TYF009/AuraBar-T113S3/docs/requirements/README.md

# Product requirements entry

The current product definition is maintained under [product scope](../product/README.md), [capability status](../product/status.md) and [roadmap](../product/roadmap.md).

The original [requirements source](requirements-source.txt) and reference images remain historical inputs. Their vehicle, BLE and smart-home examples describe possible applications rather than completed integrations. Use the current capability matrix for demonstrations and release claims.
