TYF009/AuraBar-T113S3/hardware/docs/figure-index.md

# Hardware Figure Index / 硬件图像索引

The original Word file contains 26 media files and 27 image placements: image4.png is reused once. Every unique image is preserved byte-for-byte and embedded in the [bilingual circuit handbook](hardware-design-guide.md). Figure numbers below refer to Word media numbers, not placement count. Images retain their original language and annotations.

原始 Word 含 26 个媒体文件与 27 处图片引用，其中 image4.png 重复使用一次。每张独立图均按原始字节保留，并嵌入[双语电路手册](hardware-design-guide.md)。下表图号指 Word 媒体编号，不是引用次数。图片保留原始语言与标注。

This index records provenance, not ownership of third-party illustrations. Existing licensing and source notices continue to apply. The editable author draft is not part of the current public distribution. Published figure hashes and the final schematic PDF remain verifiable without it.

本索引记录来源，不据此认定第三方插图的所有权；原有许可与来源说明继续适用。作者可编辑原稿不属于当前公开交付资料；已发布图片的哈希和最终原理图 PDF 可独立校验。

## Word figures / Word 图片

| Word media / Word 媒体 | Preserved file / 保留文件 | SHA-256 |
|---|---|---|
| `image1.png` | [t113-s3-features.png](images/t113-s3-features.png) | `62799fa843b1853c88e8eb262bdb25364b16230c3314ffe1ced6cf84b06b8af4` |
| `image2.png` | [t113-s3-block-diagram.png](images/t113-s3-block-diagram.png) | `bdadd41c85f8cc633bd78e165c0a6b41f6a68b03a8db42b6282764eabeca89d6` |
| `image3.png` | [mcu-symbol-drawing.png](images/mcu-symbol-drawing.png) | `21fb891708a23ff65d17adc97d97df721b320c01d92efe1299849102fe85c72a` |
| `image4.png` | [clock-main-24m.png](images/clock-main-24m.png) | `8a717bfa47ee2471e9a6124066d75d0849dffcb1d204a858a0fa3e3de7a03615` |
| `image5.png` | [clock-rtc-32k-schematic.png](images/clock-rtc-32k-schematic.png) | `4423d62aa3d956ca8dfdf203f86693c520efe7d2b0d5c29815c9b741e9616916` |
| `image6.png` | [reset-circuit.png](images/reset-circuit.png) | `4a0fd6c3a9aae25e9184daf33a9c3191072dcd5fe8d7c60a795c4f86433f7278` |
| `image7.png` | [power-tree-evb-reference.png](images/power-tree-evb-reference.png) | `c9db43a3922a80c57259d68b4980fc879f31926fea43cb48ecd5992fe1de9cb2` |
| `image8.png` | [power-pmic-option.png](images/power-pmic-option.png) | `29be96f791e7d860a90a0f52fd793eab9da36670a178e7f72e636575cbb326fe` |
| `image9.png` | [power-dcdc-discrete.png](images/power-dcdc-discrete.png) | `c8041ed5d22cf9c6516211073e1334d376662444d9880dc5966b329ebf470bb0` |
| `image10.jpeg` | [power-rails-original.jpeg](images/power-rails-original.jpeg) | `92b059927f96c7b6f891ce33fae12bcb8b1fa39ac003f6d189f6f12032db8357` |
| `image11.png` | [power-decoupling.png](images/power-decoupling.png) | `a49b2c3c73543fc75946ea94fdcdd2ab361ab2ca16d5727ba76ab220e24d4416` |
| `image12.png` | [mcu-final-schematic.png](images/mcu-final-schematic.png) | `bc0bc5aaf7b7fdfc6632f7177ffddbaf79b5bffbb05918eb99ee26b3761c3bc7` |
| `image13.png` | [dram-config.png](images/dram-config.png) | `b1f667ab438a1727dbf19114109fe0e63fbc615d4527cfc115a075fa0986ebeb` |
| `image14.png` | [spi-nand-flash.png](images/spi-nand-flash.png) | `ef73d651e9db0519937a6fa1069b54ab254b9f1f6f31cb6b4fb0d506352c0ad1` |
| `image15.png` | [usb-debug-typec.png](images/usb-debug-typec.png) | `a220633556aaf15f83e93468bdd64c5bca7633b69ac5e9838bfeea36932975ea` |
| `image16.png` | [led-and-button.png](images/led-and-button.png) | `d5c66affe8d34bc0ddedb66c505f0974dbf41b99f6f794f2923f67121a105852` |
| `image17.png` | [uart3-debug-port.png](images/uart3-debug-port.png) | `015a64a17f55a3aa2d7fa07e971069aeb6475c600863d1f46578f10573466e2b` |
| `image18.png` | [mic-reference-circuit.png](images/mic-reference-circuit.png) | `b4634e4f69e8a3eed55981fd05dd9fb664c376732400094046b3b22b84167fb1` |
| `image19.png` | [mic-circuit.png](images/mic-circuit.png) | `74eb14ce1370c5ff19536945f44ee7d9e384ec0fb925c6298d67b955debb1118` |
| `image20.png` | [amplifier-lm4890-reference.png](images/amplifier-lm4890-reference.png) | `aa248f0d218de2a6ee84b3f4ba2f631d898b82d2ae265144ecd0ae48c1ab415e` |
| `image21.png` | [amplifier-output.png](images/amplifier-output.png) | `45d4e2a4b0cf79c51866d3e8cae4511a5ea9ae42168ac613bc5ff2df86c8666b` |
| `image22.png` | [wifi-module-rtl8723ds.png](images/wifi-module-rtl8723ds.png) | `179e7cc85f44807aef63ca1f46c3072f7bf1f4976c97b21845c6faa8df4b2fda` |
| `image23.png` | [wifi-mcu-connections.png](images/wifi-mcu-connections.png) | `5b856f413b36e7b52481931f7c734a0487918124b604b92707a0cca842c1b97c` |
| `image24.png` | [mipi-lcd-fpc30.png](images/mipi-lcd-fpc30.png) | `48b98857427befc333d485a8e633889a157c9eb55a579730a5106d52665755b7` |
| `image25.png` | [backlight-mt9201-reference.png](images/backlight-mt9201-reference.png) | `26e18df6ca64285546816d3808fc95a0048de85c49e0b56f0f460203133f5bbe` |
| `image26.png` | [backlight-mt9201.png](images/backlight-mt9201.png) | `4467c9beee48d6ec958b4ab612f53b9de38d2c0144bfea800f51f4fabc5259c7` |

## Final schematic previews / 最终原理图预览

All seven PDF pages are rendered at 2× PDF point scale (144 dpi) without changing the PDF. The vector PDF is the preferred source for inspecting small labels. Page previews are embedded in their corresponding handbook sections.

全部七页以 PDF 点尺寸的两倍比例（144 dpi）渲染，不修改原 PDF。细小标注优先查看矢量 PDF，预览图分别嵌入手册对应章节。

| Page / 页 | Sheet / 图页 | Preview / 预览 |
|---|---|---|
| 1 | T113S3 | [01-t113s3.png](images/schematic/01-t113s3.png) |
| 2 | NET | [02-net.png](images/schematic/02-net.png) |
| 3 | POWER | [03-power.png](images/schematic/03-power.png) |
| 4 | CONNECT | [04-connect.png](images/schematic/04-connect.png) |
| 5 | AUDIO | [05-audio.png](images/schematic/05-audio.png) |
| 6 | FLASH | [06-flash.png](images/schematic/06-flash.png) |
| 7 | DISPLAY | [07-display.png](images/schematic/07-display.png) |

## Additional references / 补充参考

The handbook also retains the existing architecture diagram, RTC pin detail, power-domain copy, USB connector comparison photos, indicator and touch reference. Historical filenames do not establish revision status; captions explain the content and alternatives.

手册同时保留已有架构图、RTC 引脚细节、电源域副本、USB 连接器对比照片、指示灯与触摸参考。历史文件名不能确定版本状态，具体内容与备选方案在图注中说明。

[Machine-readable hashes / 机器可读哈希清单](figure-provenance.json) · [Final PDF / 最终 PDF](../schematic/AuraBar-Schematic-v1.0.pdf)
