TYF009/AuraBar-T113S3/docs/product/repository-review.md

# Product delivery review / 产品交付复盘

Review date: 2026-10-27. Scope: public repository presentation, source access, reproducibility and delivery evidence. This is a documentation/release review, not a new hardware acceptance run.

复盘日期：2026-10-27。范围为公开展示、源码入口、复现条件与交付证据，本次没有新增硬件实测。

## What the repository now delivers / 当前交付内容

| Area / 方面 | Assessment / 判断 | Evidence / 依据 |
|---|---|---|
| Product narrative / 产品叙事 | Clear core experience: task awareness, review cards and audio / 核心体验集中于任务、结果与音频 | [English](../../README.md), [中文](../../README.zh-CN.md) |
| Demonstration / 演示 | Film, feature GIFs, cover and bilingual subtitles / 影片、GIF、封面与双语字幕 | [Media guide](demo.md) |
| Hardware explanation / 硬件说明 | Editable electronics plus illustrated bilingual guide; author draft excluded from current tree / 电子工程与双语图文，当前目录不含原稿 | [Hardware](../hardware/README.md) |
| Evaluation / 企业评估 | Documented system boundary and integration stages / 明确系统边界与集成阶段 | [Integration brief](integration-brief.md) |
| Reproduction / 复现 | Separate paths for computer tests, matching boards and new electronics / 区分电脑、兼容板卡与新制造 | [Reproduction guide](../guides/reproduce.md) |
| Delivery availability / 下载交付 | Source is public; prepared binaries remain drafts / 源码公开，二进制仍为草稿 | [Release catalog](../releases/README.md) |

**Positioning:** a working, documented engineering platform suitable for product evaluation and adaptation. It is not yet an independently reproducible blank-board-to-production delivery.

**定位结论：**已有可工作的软硬件基础和清晰文档，适合产品评估与二次开发；尚未形成从空白板卡到量产交付的独立完整闭环。

## Highest-return next work / 后续投入优先级

| Priority / 优先级 | Work / 工作 | Done when / 完成标准 |
|---|---|---|
| P0 | Public application release / 正式提供可下载应用包 | Resolve bundled resource notices, verify manifest/hash and rollback, publish a scoped prerelease / 补齐资源声明、校验与回退后公开预发布包 |
| P0 | Reproducible system baseline / 可复现系统基线 | Document legally obtainable BSP/SDK/resources, pin versions, have a second clean environment build and run / 明确可取得的系统和 SDK，独立环境构建运行 |
| P1 | Appliance-like startup / 设备化启动体验 | One documented startup/service path, restart handling and retained user settings verified on board / 验证统一启动、重启恢复与设置保留 |
| P1 | Close physical acceptance / 完成实物验收 | Record notification/music recovery, extended playback, repeated connection cycles and boot tests / 记录提示恢复、长时间播放、反复连接及开机测试 |
| P1 | Deployment security / 部署安全 | Define non-development transport, authentication, update trust and sensitive-data handling for the intended environment / 定义非调试传输、认证、更新信任与数据处理 |
| P2 | Publication and audience / 对外传播 | Upload film, add a real YouTube link, collect feedback through reproducible use cases / 发布影片并围绕可复现使用流程收集反馈 |
| P2 | New scenarios / 扩展场景 | Demonstrate one real appliance/data adapter before adding more concept scenarios / 先完成一个真实数据接入，再扩展场景 |

The first four items improve customer confidence more than adding another visual theme. They make “inspect → obtain → run → recover” repeatable. Production commitments additionally require manufacturing, environmental and supply-chain evidence appropriate to the deployment.

前四项比新增一套视觉皮肤更能提升客户信任，因为它们把“看懂—取得—运行—恢复”变为可重复的流程。量产承诺还需要与实际场景相匹配的制造、环境和供应链依据。

## Source-publication boundary / 公开资料边界

The current hardware tree excludes editable Word author drafts. Published technical analysis, figures, EDA files, schematics and BOM remain available. The integrity check verifies figures without the draft and rejects Word files inside the hardware tree.

当前硬件目录不包含可编辑 Word 原稿，公开技术分析、图片、EDA、原理图和 BOM 保留。检查脚本无需原稿即可验证图片，并阻止硬件目录再次加入 Word。

Removing a tracked file does not erase earlier Git commits, historical branches, pull-request refs or copies already downloaded. This update does not rewrite history. Complete historical removal requires a separately coordinated repository-history cleanup, and cannot revoke external copies.

删除当前文件不会抹去旧提交、历史分支、PR 引用或已下载副本。本次未重写历史；如需进一步清理旧记录，应单独安排历史迁移，也无法撤回外部已有副本。

## Verification scope / 校验范围

Repository checks validate local documentation links, media hashes, version consistency and release metadata. Hardware checks verify 26 source figures, 27 recorded placements, all seven final schematic previews and all 41 embedded illustrations. Software behavior and acceptance records are unchanged by this presentation update.

仓库检查覆盖文档链接、媒体哈希、版本一致性和发布元数据；硬件检查覆盖 26 张来源图片、27 处记录、七页最终原理图预览与全部 41 张嵌入图片。本次展示更新未改变软件行为和原验收记录。

[Capability matrix](status.md) · [Roadmap](roadmap.md) · [CI](https://github.com/TYF009/AuraBar-T113S3/actions)
