TYF009/AuraBar-T113S3/docs/README.md

# Documentation

Choose an entry by the job you need to do. The source preview is 0.4.0-alpha.2; hardware and application concepts have separate readiness records.

| Reader | Start here | Continue with |
|---|---|---|
| Customer or integration partner | [Integration brief](product/integration-brief.md) · [Product film](product/demo.md) | [Capabilities](product/status.md), [roadmap](product/roadmap.md) |
| Reproduction / 复现 | [Reproduction guide](guides/reproduce.md) | [Development](development/README.md), [hardware](hardware/README.md) |
| Device user | [Quick start](guides/quickstart.md) | [Install/recover](guides/installation.md), [troubleshoot](guides/troubleshooting.md) |
| Software developer | [Development](development/README.md) | [Architecture](architecture/README.md), [protocol](architecture/task-protocol.md), [validation](testing/README.md) |
| Hardware developer | [Hardware design guide / 硬件设计指南](hardware/README.md) | [Circuits](../hardware/docs/hardware-design-guide.md), [interfaces](hardware/interfaces.md) |
| Release maintainer | [Release catalog](releases/README.md) | [Release procedure](releases/process.md), [changelog](../CHANGELOG.md) |

## Evidence and source records

- [Music & Focus acceptance](software/release-0.2.0-alpha.1.md)
- [Desktop Link acceptance](software/release-0.3.0-alpha.1.md)
- [Coding Companion first acceptance](software/release-0.4.0-alpha.1.md)
- [Scrolling update and owner confirmation](software/release-0.4.0-alpha.2.md)
- [Original software engineering review](software/review-v0.2.md)
- [Asset classifications and provenance](../assets/README.md)

中文首页见 [README.zh-CN.md](../README.zh-CN.md)。使用者可从快速开始进入，工程细节按产品、硬件、架构、开发、测试和发布组织。
