TYF009/AuraBar-T113S3/docs/requirements/requirements-source.txt

设计一款通用的嵌入式产品解决方案。可以成为个人桌面助理屏，可以触摸控制、可以通过屏幕查看时间、查看天气、设置番茄时钟，一个长且大的屏幕，放在使用者工作台上，有熄屏控制、音量控制功能，后续可扩展小游戏、HID快捷键，也可以加入BLE Mesh组网多设备中控功能。或者可以内嵌入冰箱，或成为汽车的数字仪表盘显示里程，目前档位以及当前速度。之所以不用STM32F103芯片是因为主频太低了，这会导致驱动较大屏幕时，刷新帧率不够，另外没有显示接口，没有音频编解码器等等。
