TYF009/AuraBar-T113S3/docs/software/release-0.4.0-alpha.1.md

# Coding Companion 0.4.0-alpha.1 — preview acceptance record

Date: 2026-10-25. This is an application preview with the remaining checks listed below.
The Music & Focus 0.2 and Desktop Link 0.3 iterations remain on their existing branches.

## Delivered source

- A standard-library Python Codex CLI adapter consumes actual exec JSONL events.
- A schema-constrained review card separates AI summary, observed command exits,
  AI verification notes and human follow-up actions.
- A model-reported blocked outcome is not shown as a completed task.
- Per-run local prompt, event, stderr and result files; bounded input/events,
  local cancellation, timeout, and result preservation if delivery fails.
- Optional schema-1 evidence/next_step fields retain older-reader compatibility.
- Native task-page source adds Summary / Evidence / Next tabs and scrollable text.
- Product scope, setup, example prompt and package/deploy profile updated for 0.4.

## Verified on the development computer and USB transport

The Python regression suite covers: command exits and duplicate events, UTF-8 bounds,
card validation, invalid/missing results after a zero CLI exit, model-reported blockers,
initial-delivery failure preventing execution, timeout, local result preservation after
service loss, and the existing companion authentication/command tests.
The test CLI is a local fixture; these regressions do not invoke a model.

Separately, an actual logged-in Codex CLI (0.164.0-alpha.11.1) completed a Chinese
static review of a small percentage function supplied in the task. The card identified
unknown/zero denominator handling and follow-up boundary tests, and explicitly stated
that no commands, tests or file modifications were performed. The adapter recorded
zero observed command exits, saved the full result, and the USB bridge delivered the
matching task id and Chinese result to /tmp/aurabar-tasks.json on the real board.
This verifies a real model result and USB delivery, not an end-to-end coding/test verdict.

An earlier attempt using a stale system proxy timed out and reported failure. Retrying
with the current system proxy restored model connectivity. A project-file reading task
then returned a card stating that the local Codex shell sandbox could not initialize
due to access denial on its sandbox helper directory. That did not verify file reading
or test execution. The blocked-outcome mapping was added after this observation and is
covered by regression tests; the earlier task was not retroactively rewritten.

## Pending acceptance / 待验收

- The owner confirmed all three tabs and long-text scrolling work, but reported
  choppy scrolling. Alpha.2 addresses redundant UI updates; performance acceptance
  remains separate from this functional confirmation.
- Recheck terminal notification audio during music, followed by music recovery.
- Resolve the computer's Codex sandbox permission issue before claiming project-file
  reading, command execution or actual test-suite integration on this machine.

## Ubuntu build, real board and package

The VMware runtime share was re-enabled and mounted in Ubuntu; the owner restarted
the existing build helper. The full Ubuntu regression job coding-04-tests-01 exited
zero, including all 13 Python tests, native task model/HTTP worker/music tests, and
ARM test executable compilation. The new task-model executable also passed on T113.

A fresh RelWithDebInfo T113 build (coding-04-build-01) exited zero. The 4,734,664-byte
binary was installed at /usr/bin/aurabar-coding-companion-0.4.0-alpha.1 and returned
the correct version. Host and device SHA256 both matched:

```text
b10243bbea4a45a2aa9138a964e80333cc3ba38b71605298c3b6dc6065747de7
```

The old display process was stopped and the new app started with --tasks and the
existing USB snapshot path. Framebuffer inspection showed Coding Companion, all
three tabs, a connected heartbeat, Chinese AI summary text and its scroll bar.
Original /usr/bin/demo, the 0.2/0.3 executables and boot configuration were preserved.

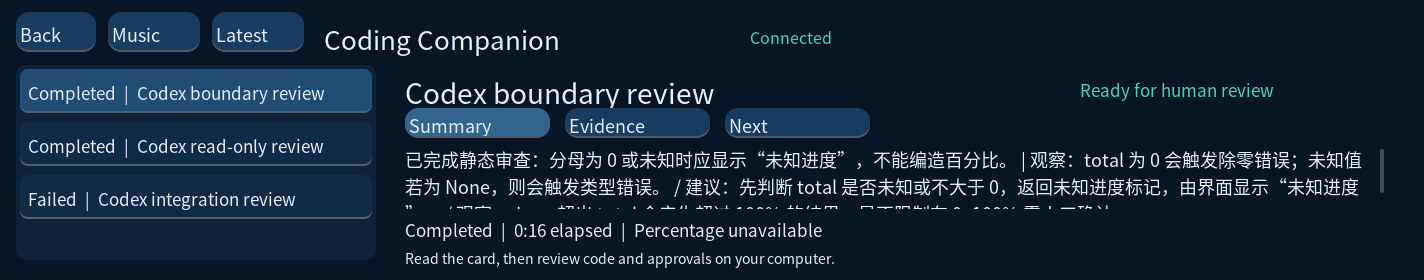
[picture p14: docs/software/images/coding-summary-board.png]
Actual T113 framebuffer: Coding Companion summary


The archive aurabar-coding-companion-0.4.0-alpha.1-t113.tar.gz passed verification of
all 142 manifest files, including the adapter, schema and sample prompt. It is an
application upgrade, not a bootable firmware image. Archive SHA256:

```text
0c86230fc2f42b2b398ad83f4ed8dd034dd865e27605afe21b51b203acd8d412
```

## Scope limits

This tracks tasks launched by the companion, not every conversation in the desktop
Codex app. It does not offer screen approvals, task launch/cancel buttons, durable
task storage, automatic startup, whole-system flashing or a bundled local model.
AI-generated summaries and outcomes still need human review.

See [setup](../../software/companion/README.md) and [product scope](coding-companion.md).
