TYF009/AuraBar-T113S3/assets/renders/ai-workspace.webp

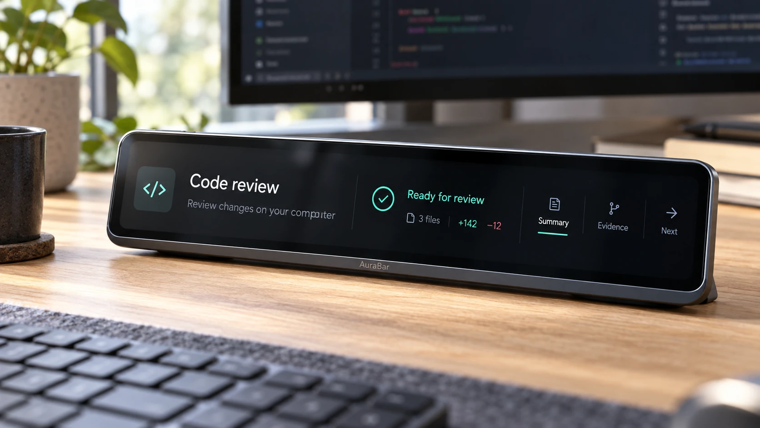
assets/renders/ai-workspace.webp
