TYF009/AuraBar-T113S3/docs/requirements/images/car-dashboard-example.png

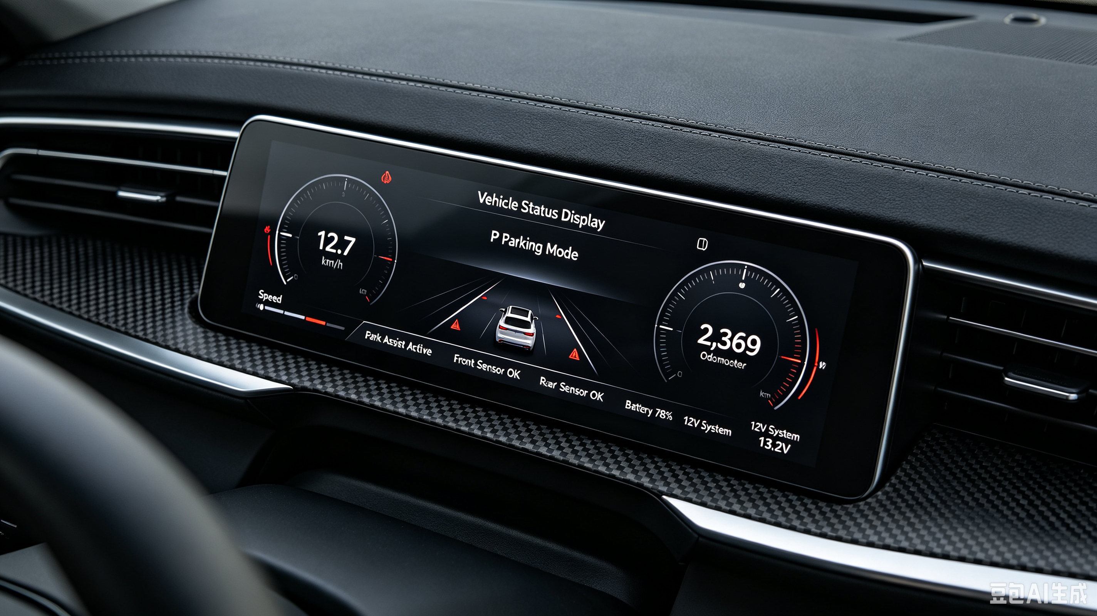
docs/requirements/images/car-dashboard-example.png
