TYF009/AuraBar-T113S3/docs/requirements/images/fridge-example.png

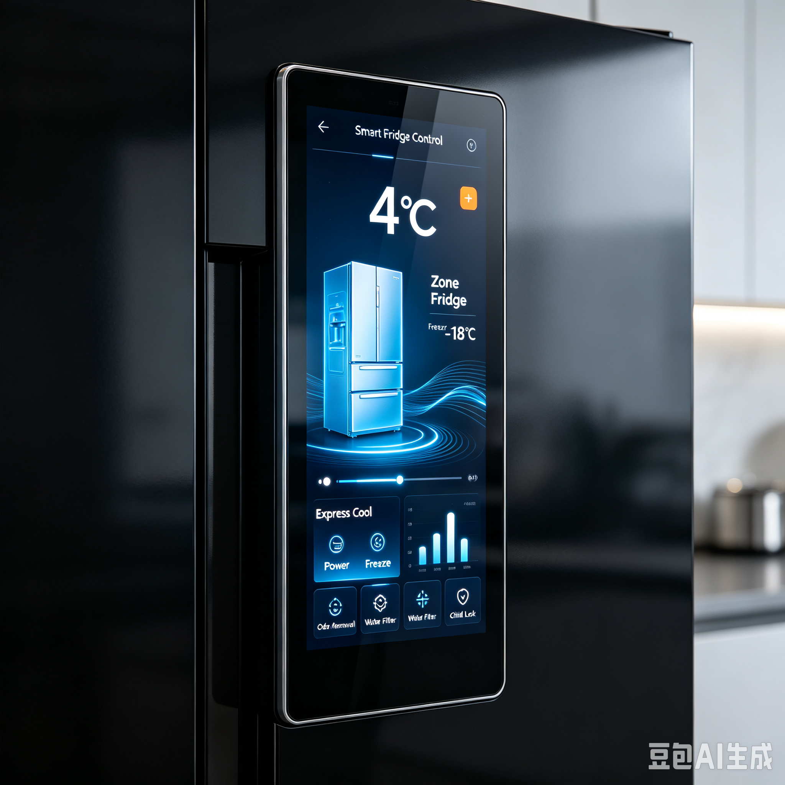
docs/requirements/images/fridge-example.png
