TYF009/AuraBar-T113S3/hardware/schematic/dxf/T113S3.dxf

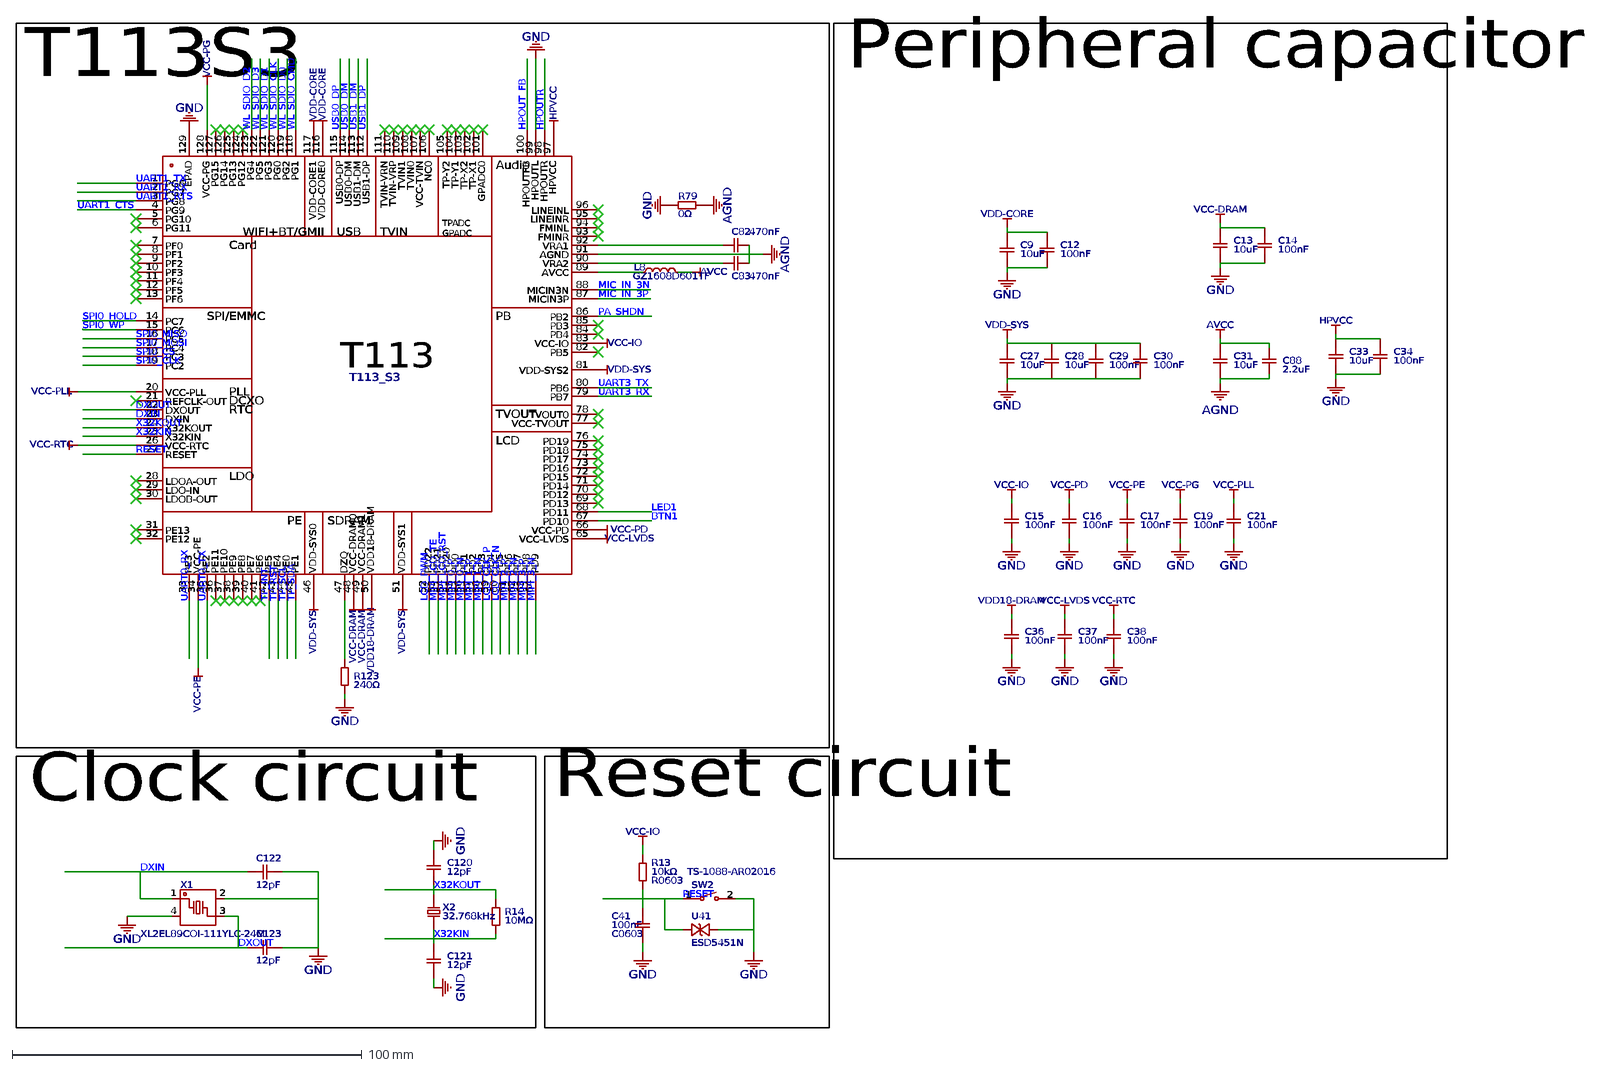
[picture p19: CAD file, 2026-10-07]
hardware/schematic/dxf/T113S3.dxf
Peripheral capacitor
Reset circuit
Clock circuit
T113S3
X1
XL2EL89COI-111YLC-24M
1
3
4
2
GND
AGND
R14
10MΩ
R13
R0603
10kΩ
T113_S3
WIFI+BT/GMII
DCXO
PLL
LDO
TPADC GPADC
Audio
PE
SDRAM
LCD
SPI/EMMC
Card
RTC
TVOUT
PB
TVIN
USB
T113
PG6
PG7
PG8
PG9
PG10
5
PG11
6
PF0
7
PF1
8
PF2
9
PF3
10
PF4
11
PF5
12
PF6
13
PC7
14
PC6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
