TYF009/AuraBar-T113S3/hardware/schematic/dxf/POWER.dxf

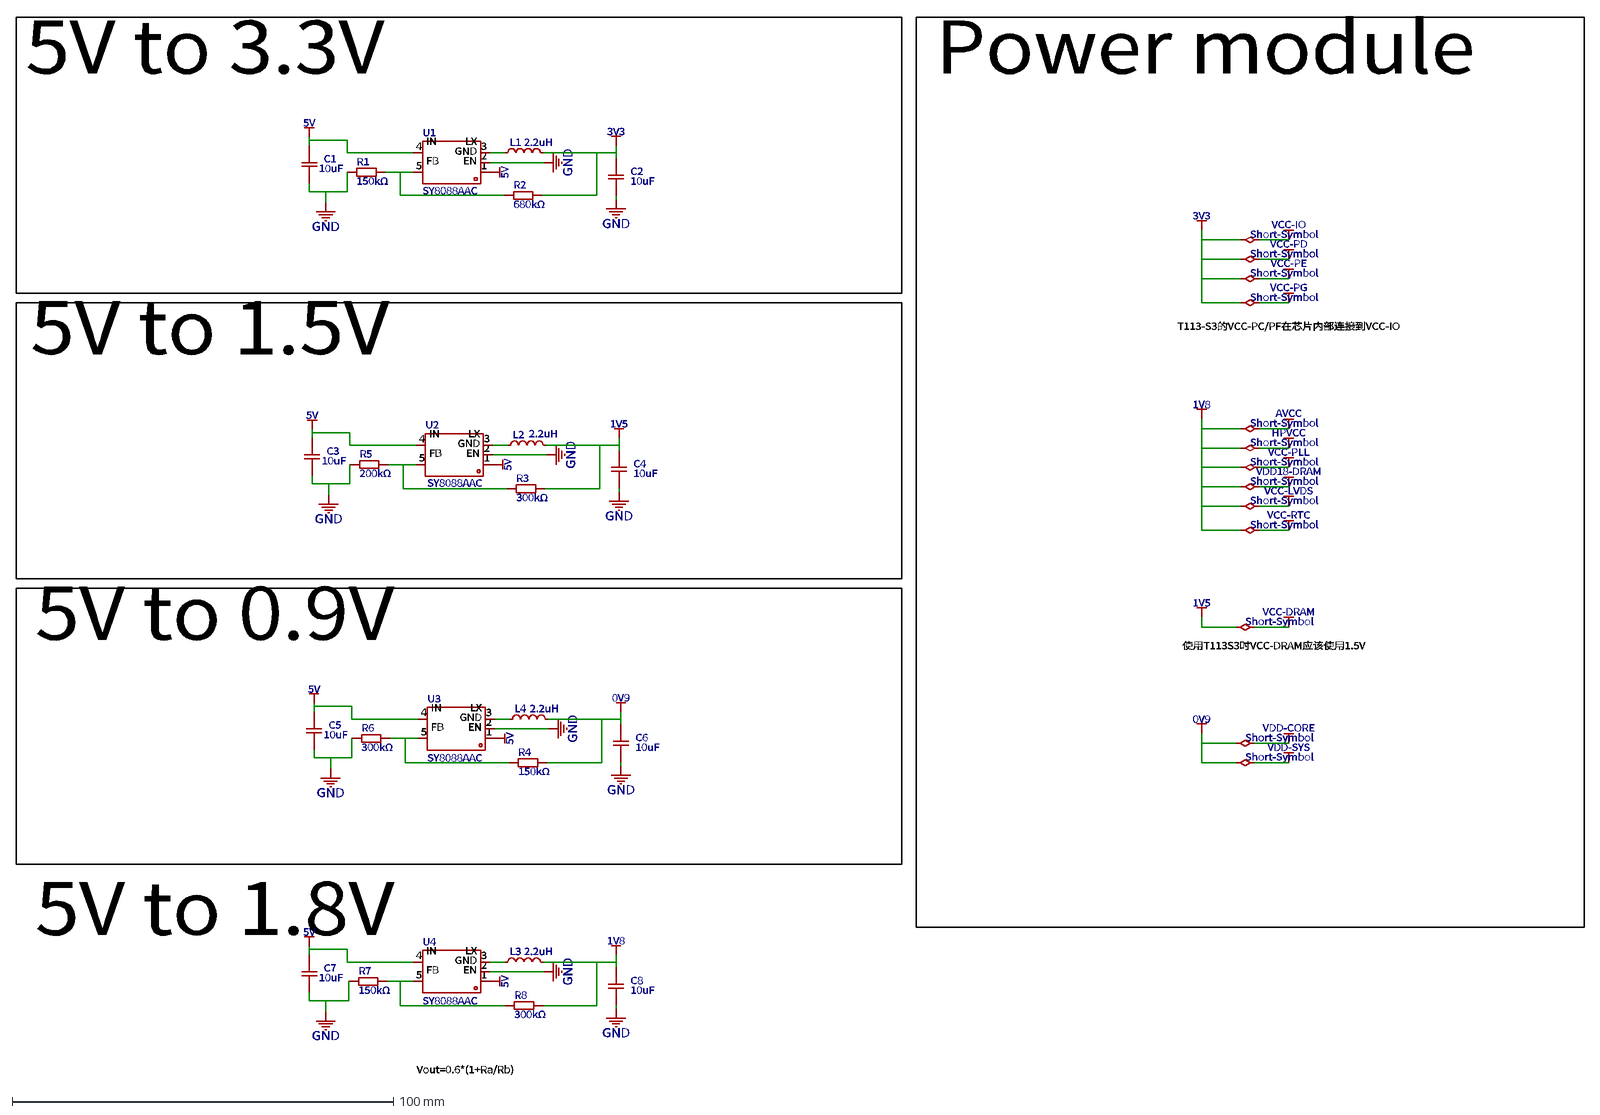
[picture p20: CAD file, 2026-10-07]
hardware/schematic/dxf/POWER.dxf
Vout=0.6*(1+Ra/Rb)
Power module
5V to 1.8V
5V to 0.9V
5V to 1.5V
5V to 3.3V
T113-S3的VCC-PC/PF在芯片内部连接到VCC-IO
使用T113S3时VCC-DRAM应该使用1.5V
U1
SY8088AAC
EN
1
GND
2
LX
3
IN
4
FB
5
U2
U3
U4
R1
150kΩ
R4
R7
R2
680kΩ
C1
10uF
C2
C3
C4
C5
C6
C7
C8
5V
3V3
1V5
0V9
1V8
R3
300kΩ
R5
200kΩ
R6
R8
VDD-CORE
VDD-SYS
AVCC
HPVCC
VCC-PLL
VDD18-DRAM
VCC-LVDS
VCC-RTC
VCC-IO
VCC-PD
VCC-PE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
