TYF009/AuraBar-T113S3/hardware/schematic/dxf/FLASH.dxf

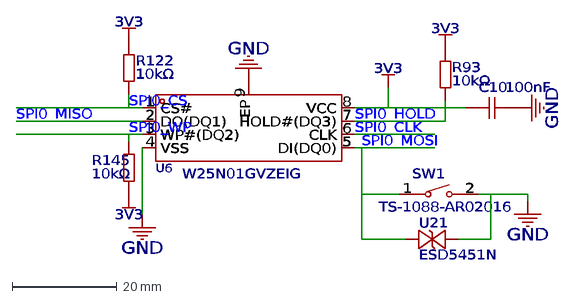
[picture p21: CAD file, 2026-10-07]
hardware/schematic/dxf/FLASH.dxf
GND
3V3
C10
100nF
SW1
TS-1088-AR02016
2
1
R93
10kΩ
R122
R145
U21
ESD5451N
U6
W25N01GVZEIG
CS#
DO(DQ1)
WP#(DQ2)
3
VSS
4
DI(DQ0)
5
CLK
6
HOLD#(DQ3)
7
VCC
8
EP
9
SPI0_HOLD
SPI0_CLK
SPI0_WP
SPI0_MOSI
SPI0_MISO
SPI0_CS
