TYF009/AuraBar-T113S3/hardware/schematic/dxf/AUDIO.dxf

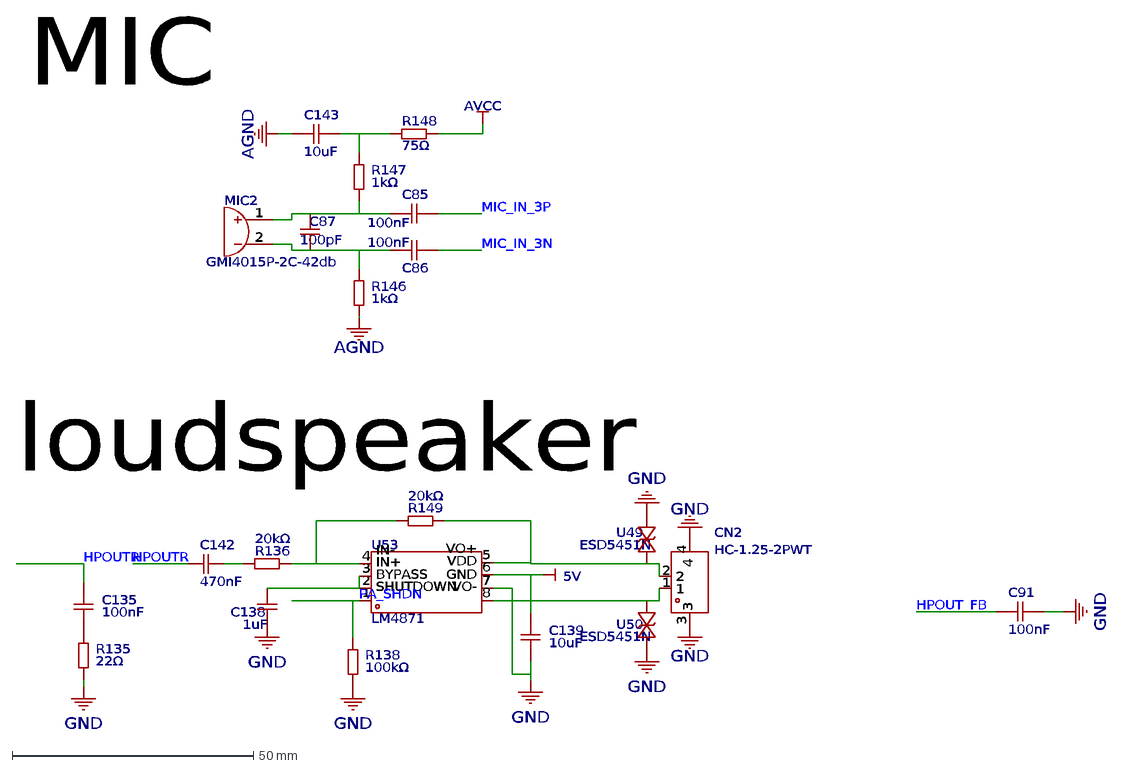
[picture p22: CAD file, 2026-10-07]
hardware/schematic/dxf/AUDIO.dxf
MIC
loudspeaker
C85
100nF
C86
C91
AVCC
5V
AGND
GND
C135
C139
10uF
C143
U49
ESD5451N
U50
C142
470nF
C87
100pF
R135
22Ω
R136
20kΩ
R149
C138
1uF
R138
100kΩ
CN2
HC-1.25-2PWT
1
2
3
4
R146
1kΩ
R147
R148
75Ω
MIC2
GMI4015P-2C-42db
U53
LM4871
SHUTDOWN
BYPASS
IN+
IN-
VO+
5
VDD
6
7
VO-
8
MIC_IN_3P
PA_SHDN
HPOUTR
HPOUT_FB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
