TYF009/AuraBar-T113S3/hardware/schematic/dxf/NET.dxf

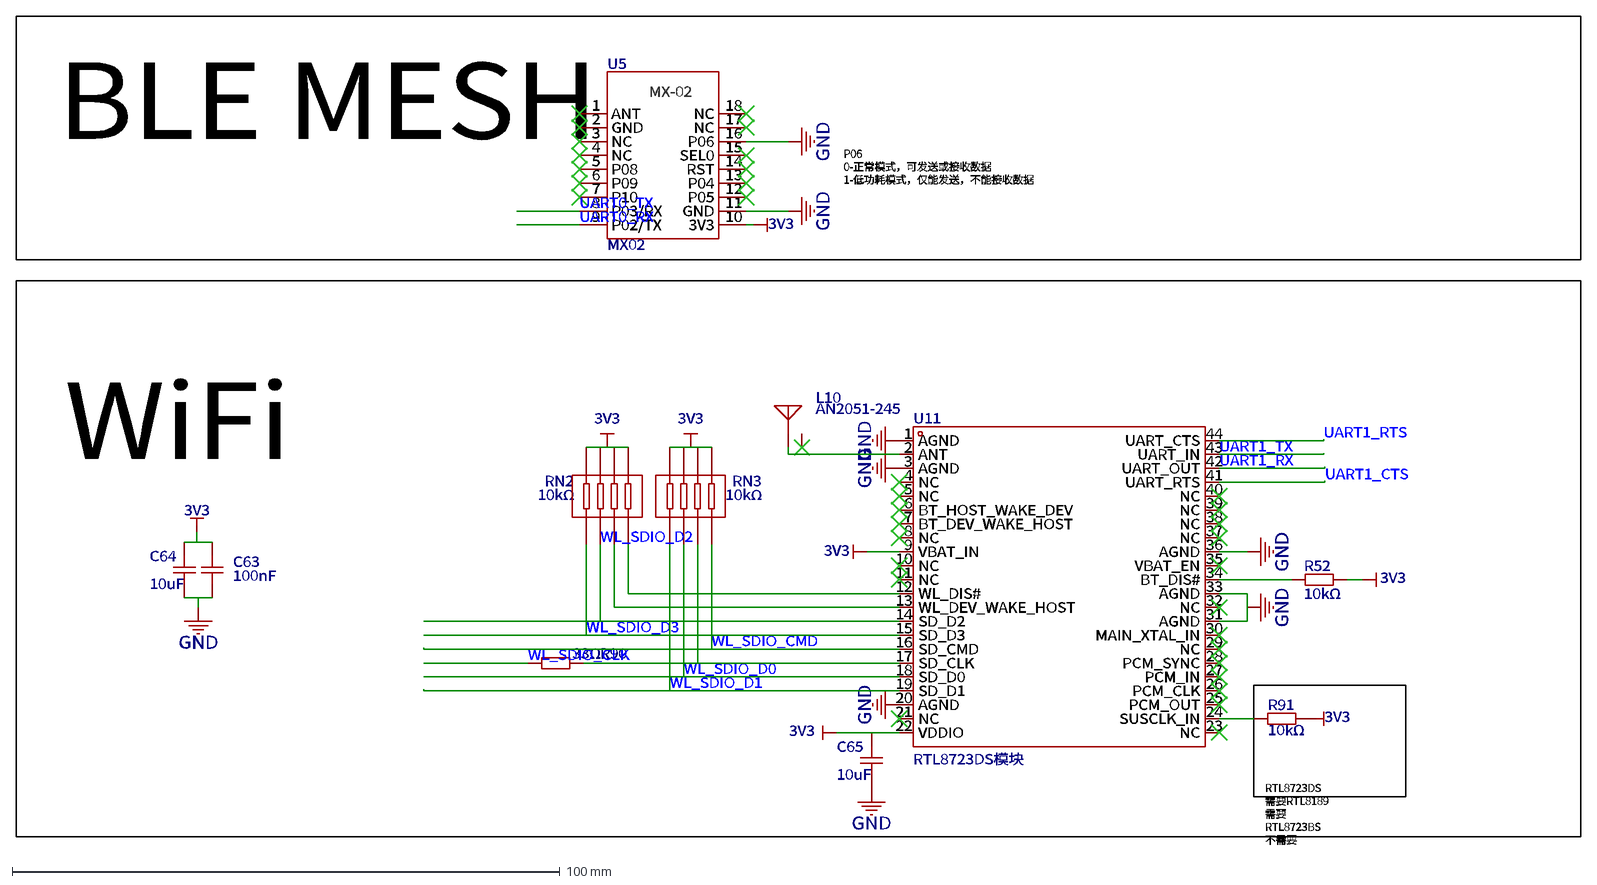
[picture p23: CAD file, 2026-10-07]
hardware/schematic/dxf/NET.dxf
WiFi
BLE MESH
P06 0-正常模式，可发送或接收数据 1-低功耗模式，仅能发送，不能接收数据
RTL8723DS 需要 RTL8189 需要 RTL8723BS 不需要
R91
10kΩ
GND
3V3
U11
RTL8723DS模块
AGND
1
ANT
2
3
NC
4
5
BT_HOST_WAKE_DEV
6
BT_DEV_WAKE_HOST
7
8
VBAT_IN
9
10
11
WL_DIS#
12
WL_DEV_WAKE_HOST
13
SD_D2
14
SD_D3
15
SD_CMD
16
SD_CLK
17
SD_D0
18
SD_D1
19
20
21
VDDIO
22
23
SUSCLK_IN
24
PCM_OUT
25
PCM_CLK
26
PCM_IN
27
PCM_SYNC
28
29
MAIN_XTAL_IN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
