TYF009/AuraBar-T113S3/hardware/schematic/dxf/DISPLAY.dxf

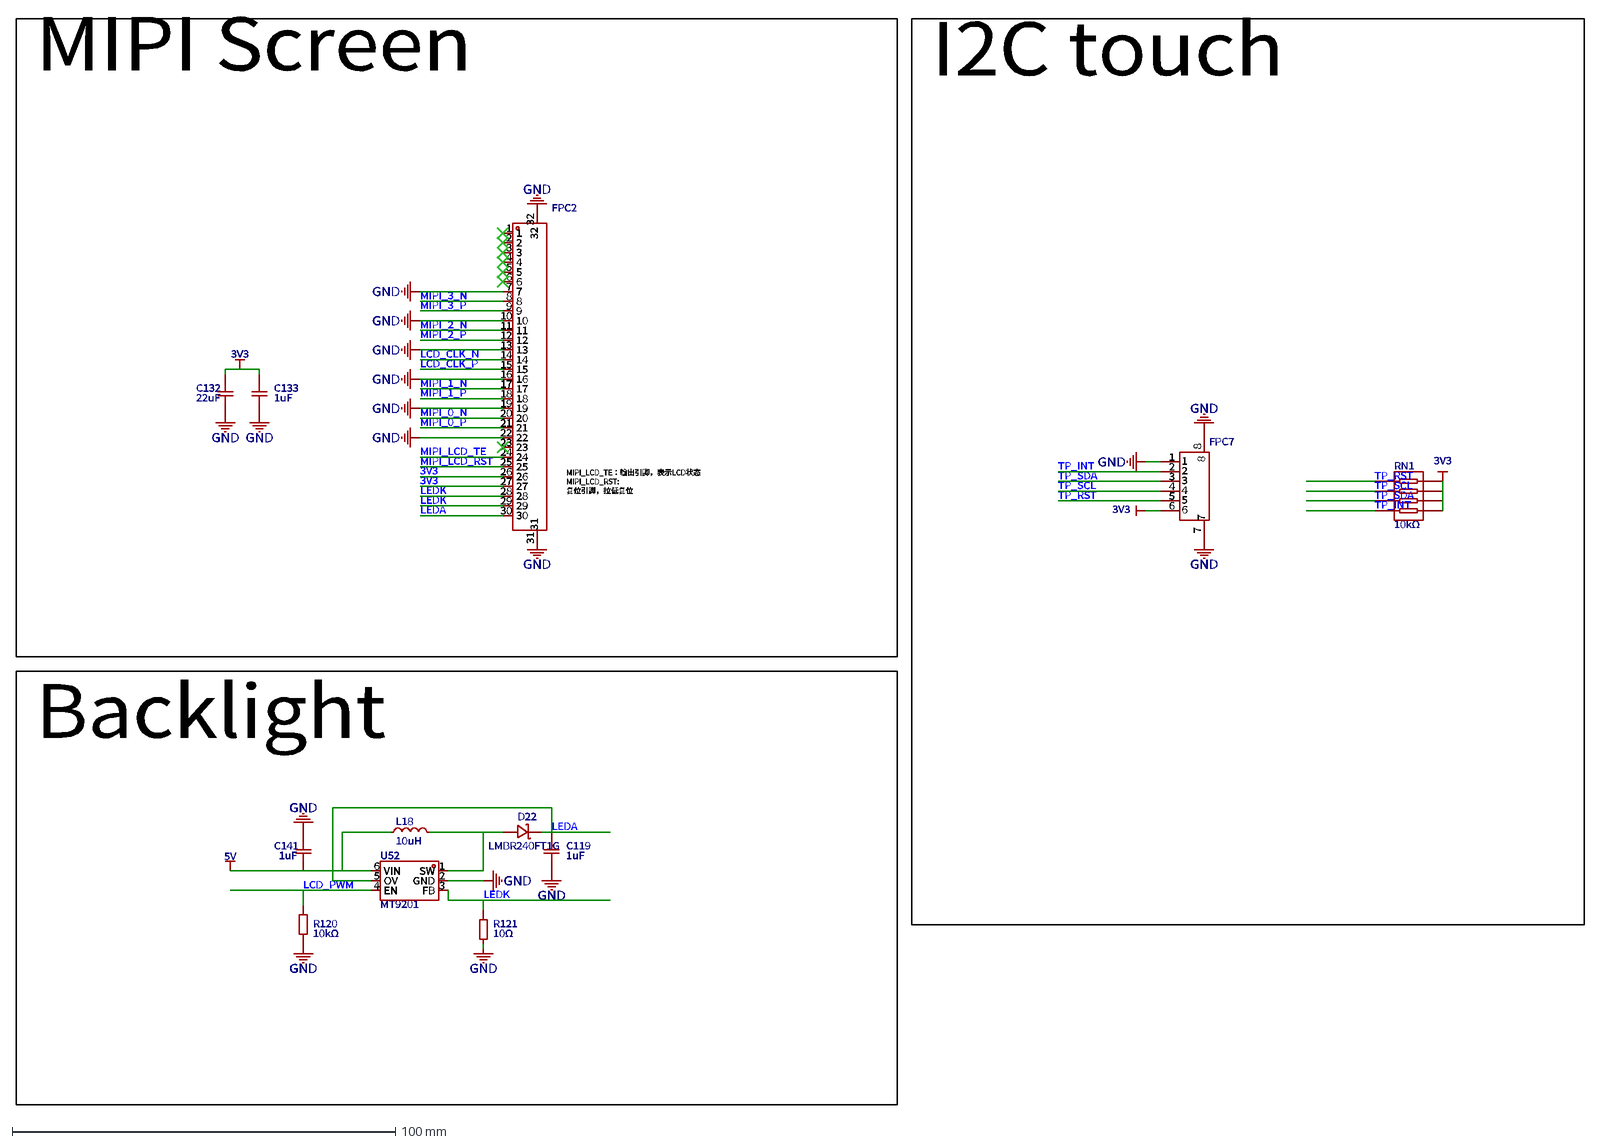
[picture p24: CAD file, 2026-10-07]
hardware/schematic/dxf/DISPLAY.dxf
I2C touch
Backlight
MIPI Screen
MIPI_LCD_TE：输出引脚，表示LCD状态 MIPI_LCD_RST: 复位引脚，拉低复位
RN1
10kΩ
3V3
R120
GND
D22
LMBR240FT1G
5V
R121
10Ω
C119
1uF
C133
C141
FPC2
1
2
3
4
5
6
7
8
9
10
11
12
13
14
15
16
17
18
19
20
21
22
23
24
25
26
27
28
29
30
31
32
L18
10uH
C132
22uF
FPC7
U52
MT9201
SW
FB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
