TYF009/AuraBar-T113S3/hardware/schematic/dxf/CONNECT.dxf

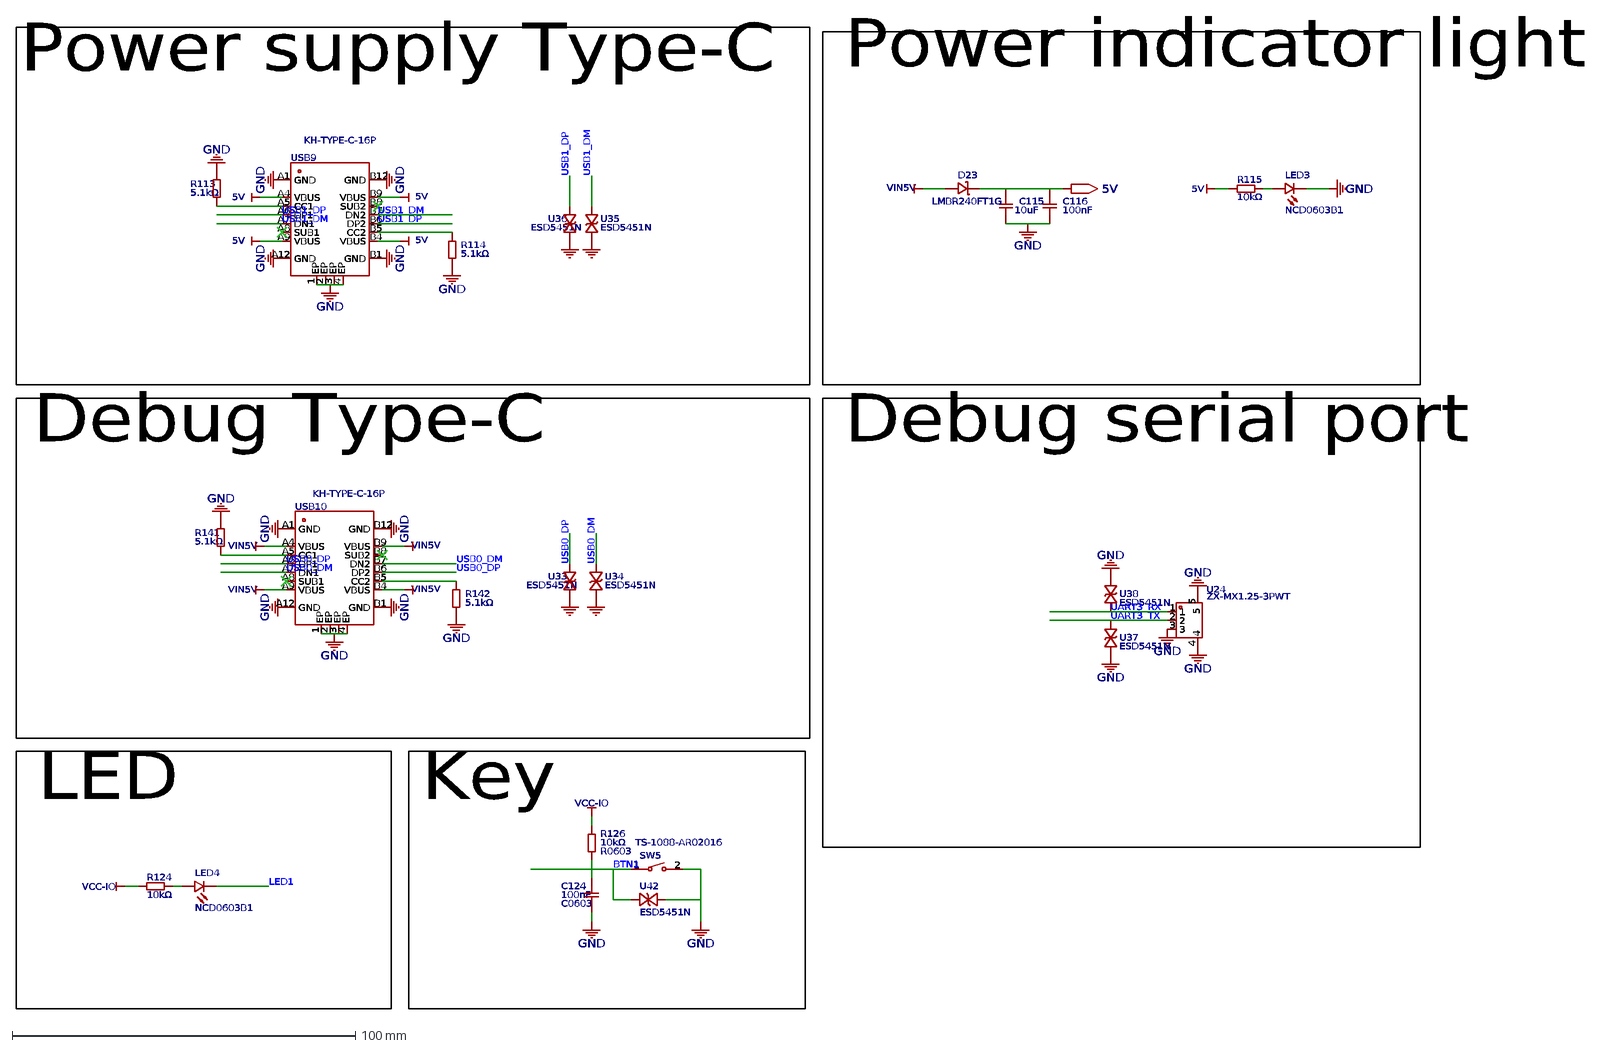
[picture p25: CAD file, 2026-10-07]
hardware/schematic/dxf/CONNECT.dxf
Power indicator light
Debug serial port
Key
LED
Debug Type-C
Power supply Type-C
GND
5V
VIN5V
C115
10uF
C116
100nF
VCC-IO
R115
10kΩ
R124
U33
ESD5451N
U34
U35
U36
U37
U38
U42
R126
R0603
C124
C0603
SW5
TS-1088-AR02016
2
1
R113
5.1kΩ
R114
R141
R142
LED3
NCD0603B1
LED4
U24
ZX-MX1.25-3PWT
3
4
5
USB9
KH-TYPE-C-16P
A12
VBUS
A9
SUB1
A8
DN1
A7
DP1
A6
CC1
A5
A4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
