TYF009/AuraBar-T113S3/CHANGELOG.md

# Changelog

This log separates source changes from binary publication. The historical previews below were built/tested on 2026-10-25; their binary publications remain drafts.

## Unreleased — repository productization

- Product-film and GIF showcase, refreshed bilingual landing pages, integration brief and reproduction workflow.
- Removed the editable hardware author draft from the current public tree; retained illustrated engineering analysis and independently verified figure hashes.
- Added a hardware author-draft publication guard and media integrity coverage. Software version and acceptance claims are unchanged.

- Product-oriented English/Chinese entry points, classified concept assets and actual screenshots.
- Product readiness, architecture/protocol, hardware, setup/recovery, development and release documentation.
- Repository integrity/version checks, environment diagnostics and contribution templates.
- Integration of the three tested software iterations into the default branch, retaining history.

## 0.4.0-alpha.2 — Coding Companion

- Avoid redundant task-page label/style updates; refresh selections immediately and constrain short-panel overscroll.
- Select displayed task ids rather than stale row indexes.
- Owner confirmed smoother scrolling and ambient playback/pause. [Evidence](docs/software/release-0.4.0-alpha.2.md).

## 0.4.0-alpha.1 — first Codex preview

- Actual Codex JSONL adapter, schema-constrained review cards, command-exit evidence, blockers, timeout and local results.
- Summary/Evidence/Next UI. [Evidence](docs/software/release-0.4.0-alpha.1.md).

## 0.3.0-alpha.1 — Desktop Link

- Local authenticated task service, real command wrapper, USB bridge, heartbeat/reconnect and completion event deduplication.
- Board task list and shared music navigation. [Evidence](docs/software/release-0.3.0-alpha.1.md).

## 0.2.0-alpha.1 — Music & Focus

- Native local/stream MP3 and WAV playback, synthesized textures and controls.
- Storage/thread/queue/timer corrections, target builds and checksummed application bundles. [Evidence](docs/software/release-0.2.0-alpha.1.md).
