TYF009/AuraBar-T113S3/hardware/schematic/AuraBar-Schematic-v1.0.pdf

T113S3

# Peripheral capacitor

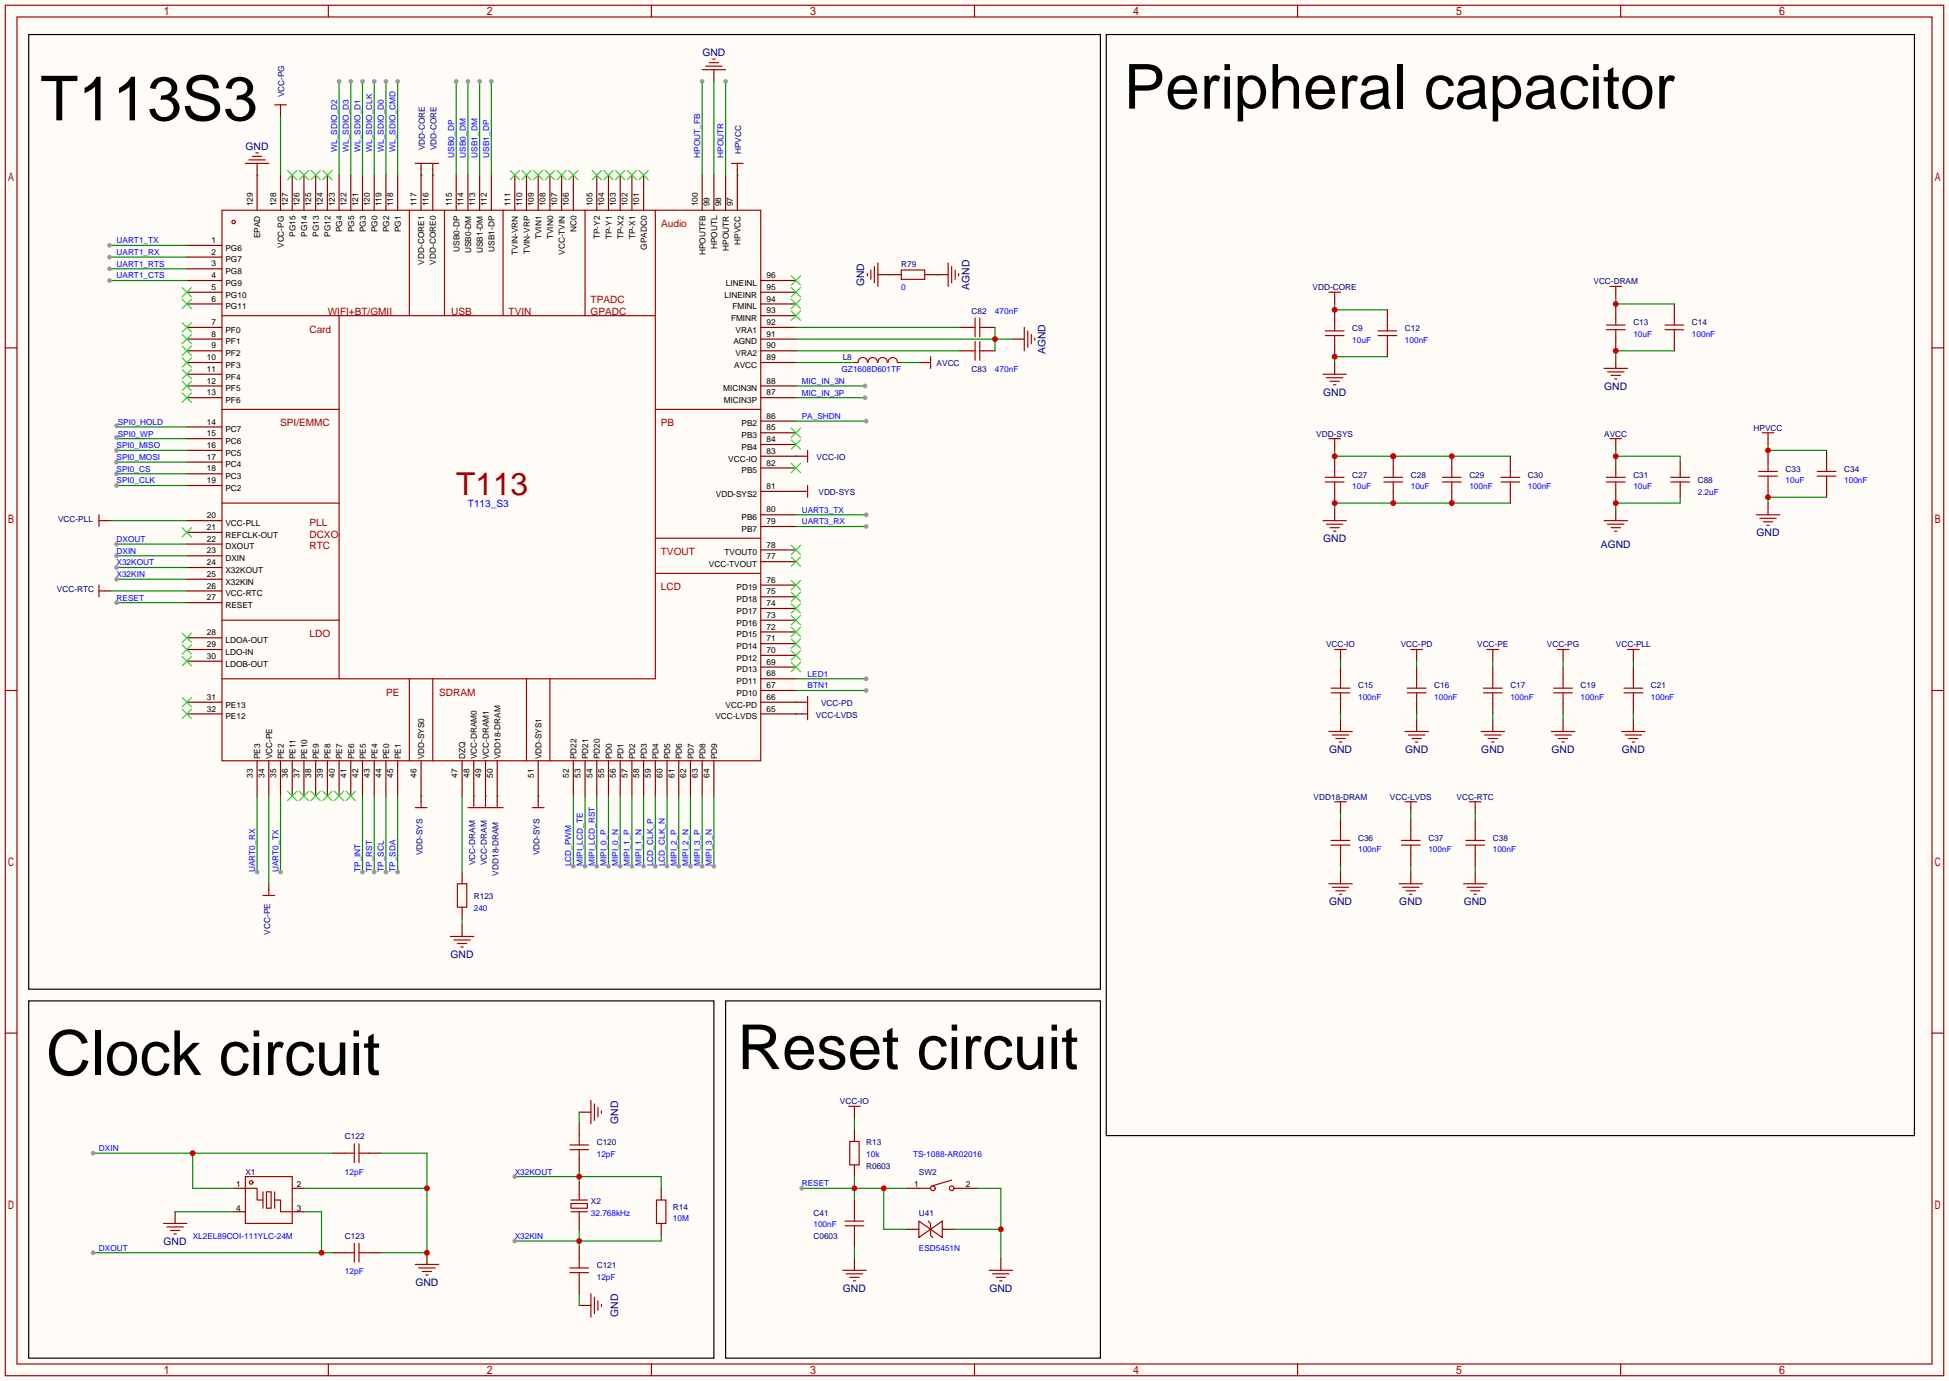
[picture p65: page 1]

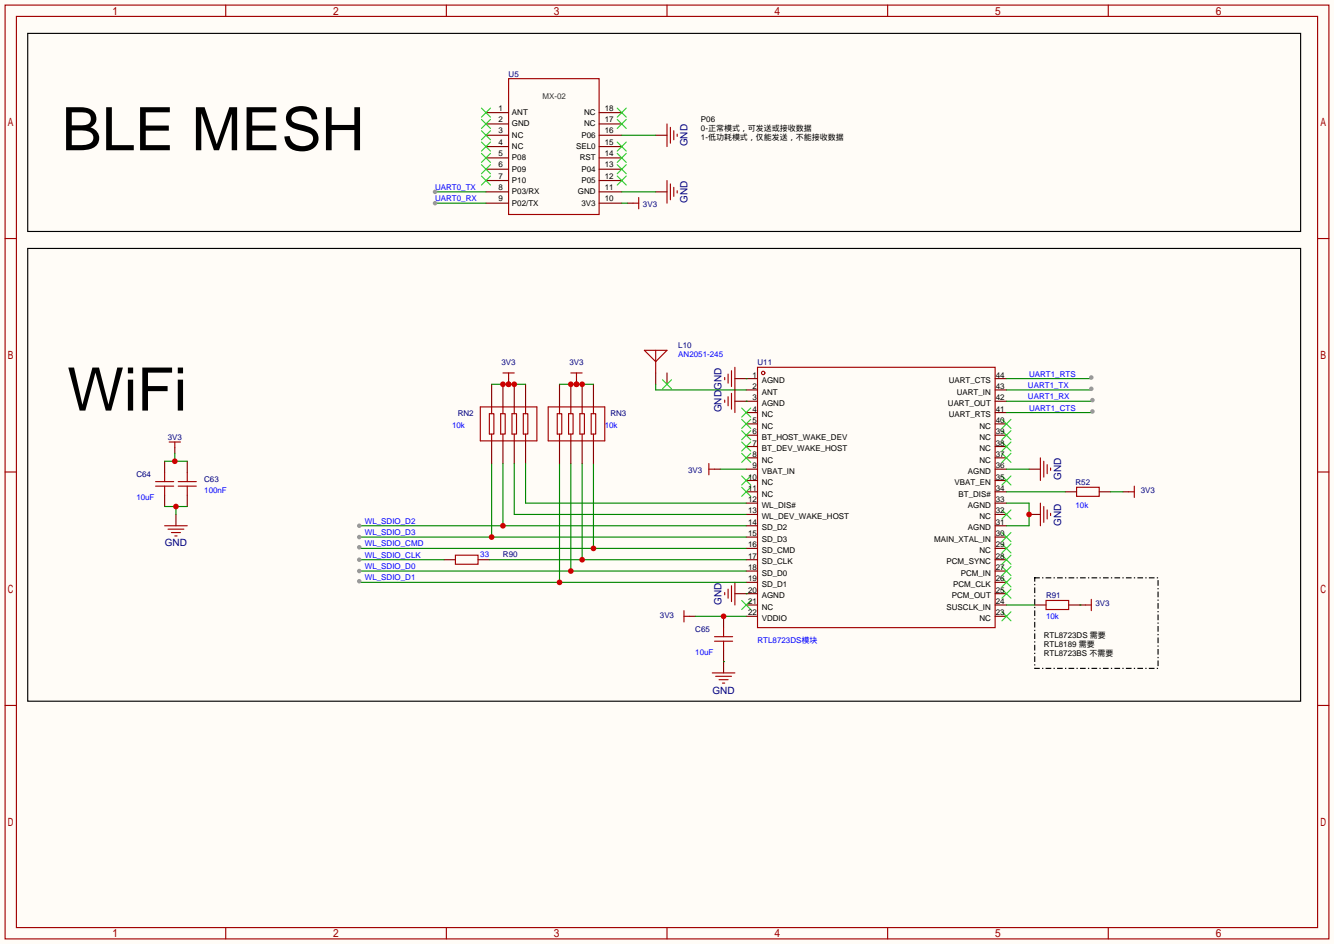
[picture p66: page 2]

# 5V to 3.3V

# Power module

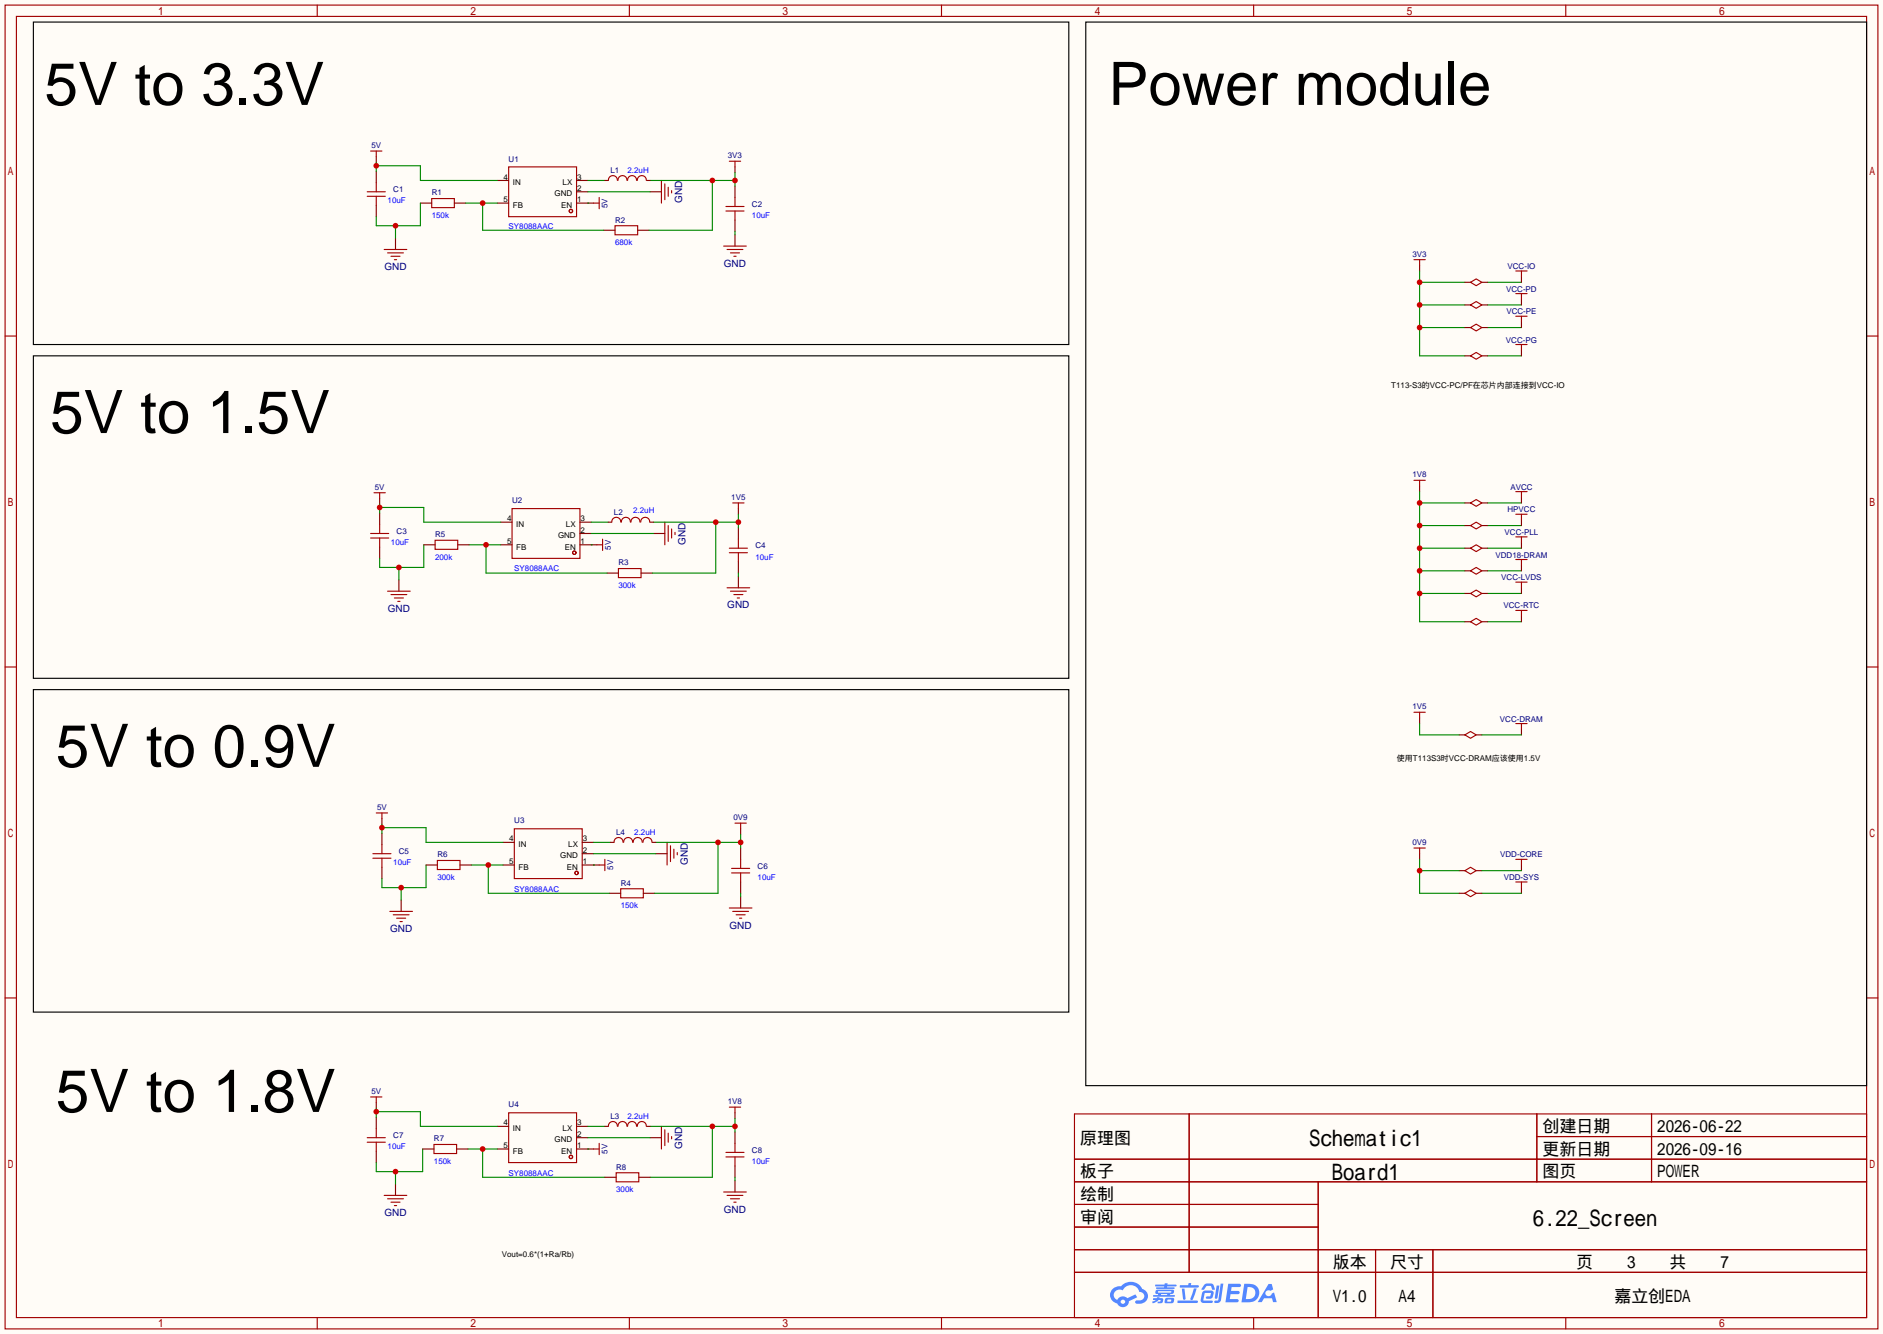
[picture p67: page 3]

原理图 | Schematic1 | 创建日期 | 2026-06-22

更新日期 | 2026-09-16

板子 | Board1 | 图页 | POWER
绘制 | | 6.22_Screen
审阅

V1.0 | A4 | 嘉立创EDA

# VBUS A9 SUB1 A8 DN1 A7 DP1 A6 CC1 A5 VBUS A4

# Power supply Type-C

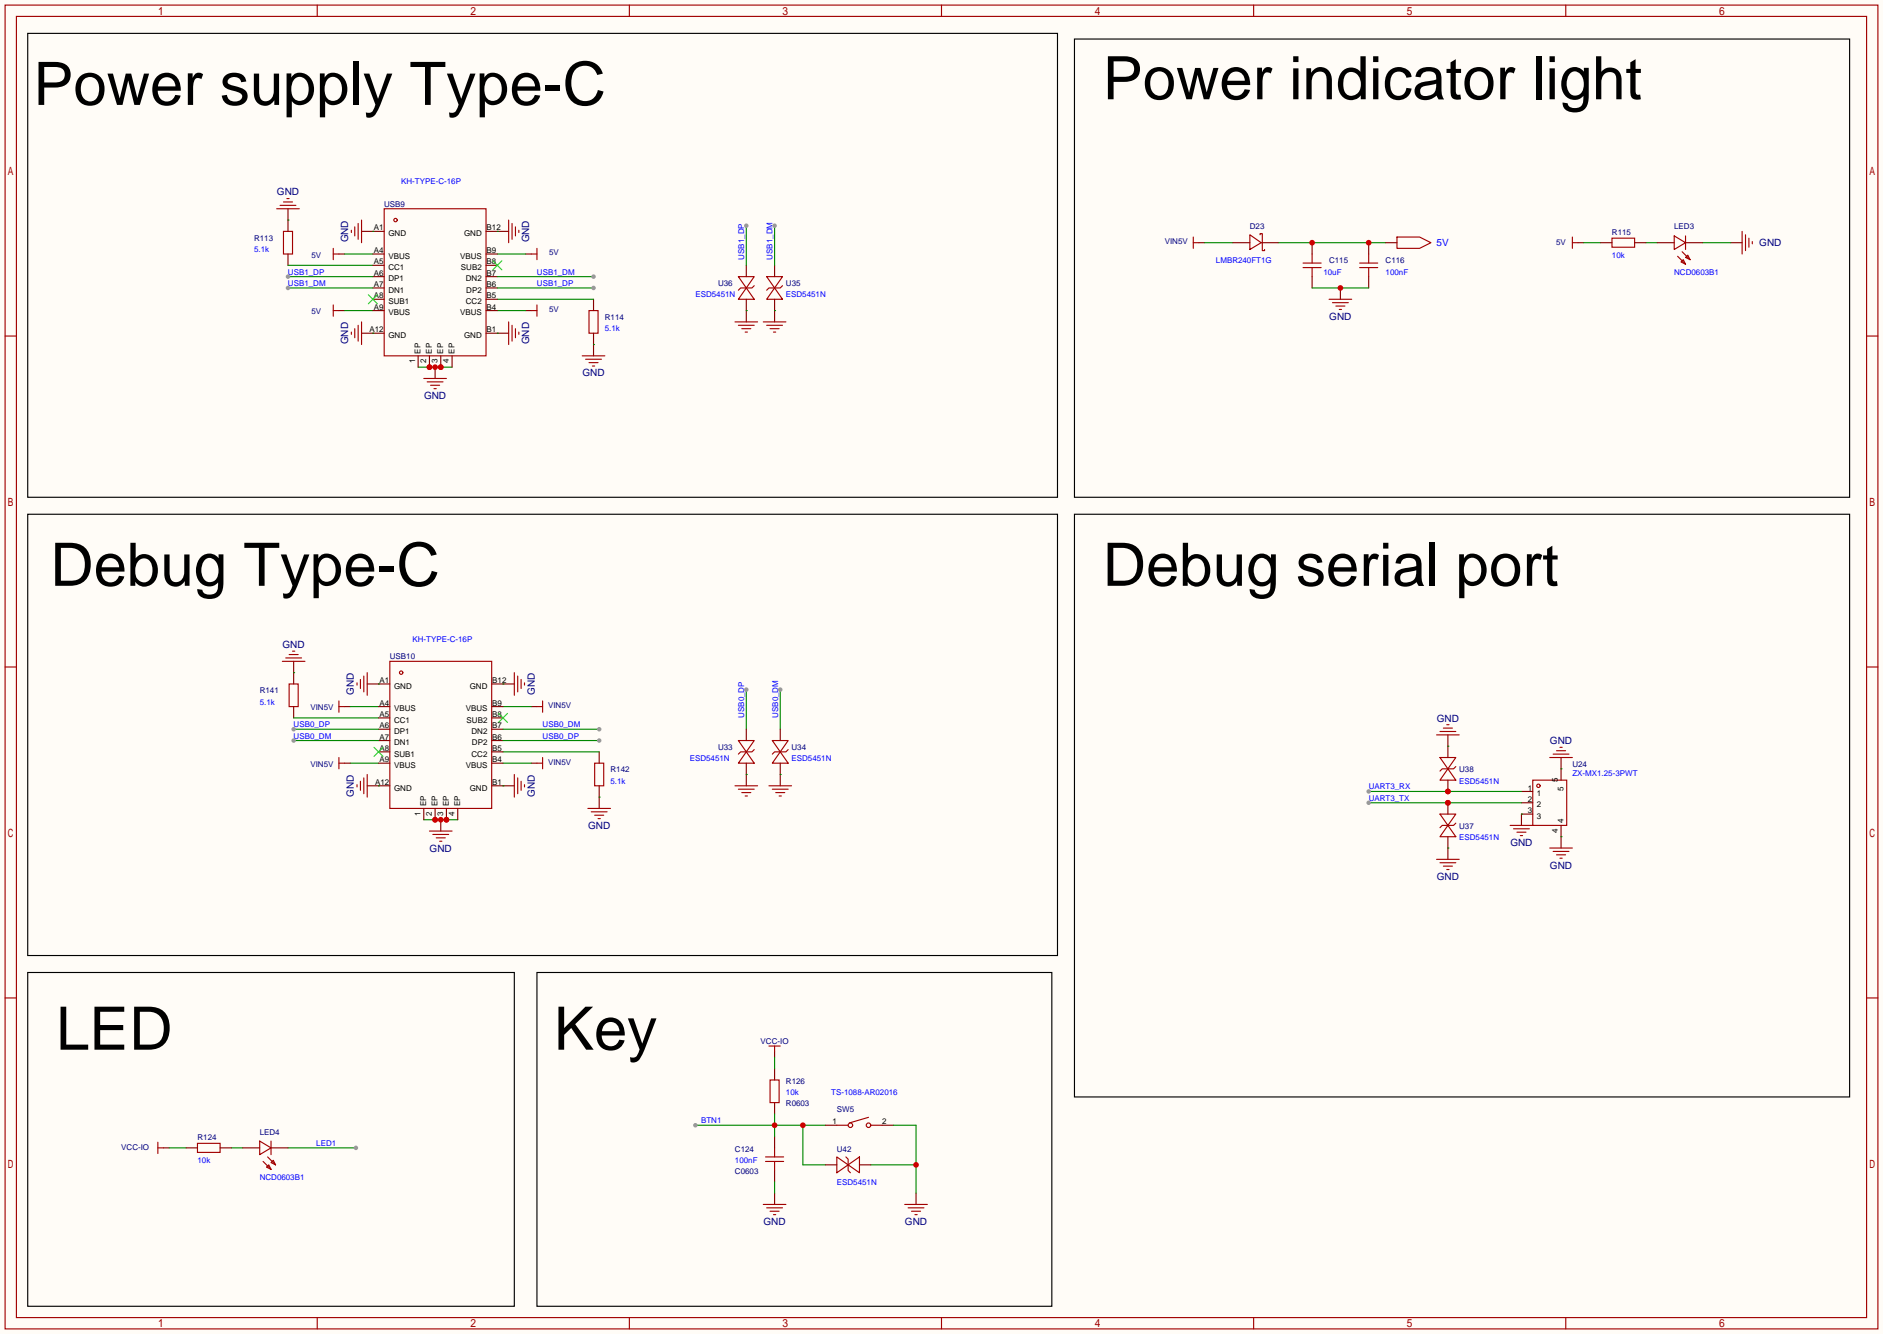
[picture p68: page 4]

# MIC

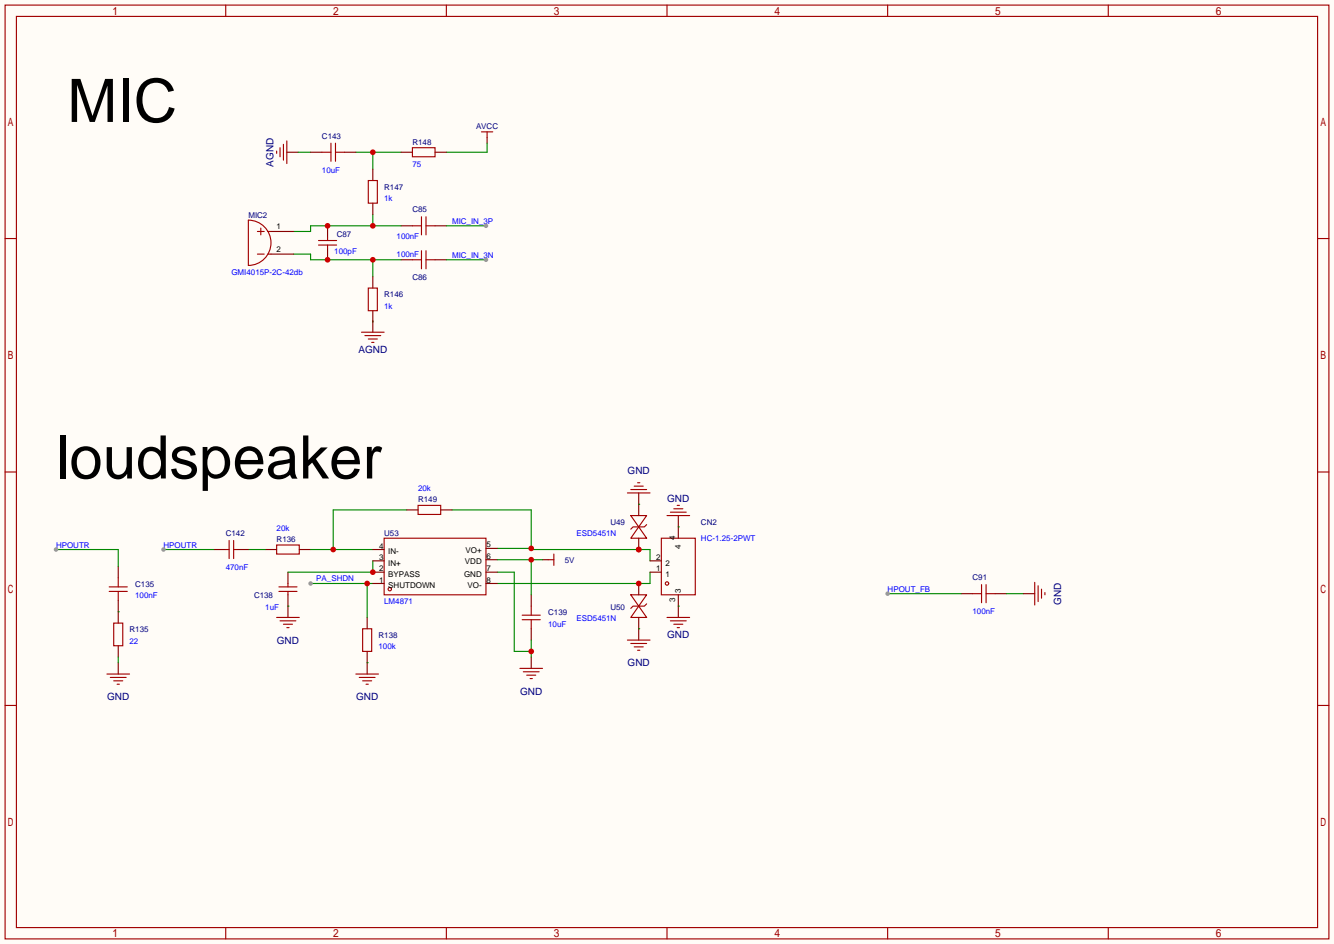
[picture p69: page 5]

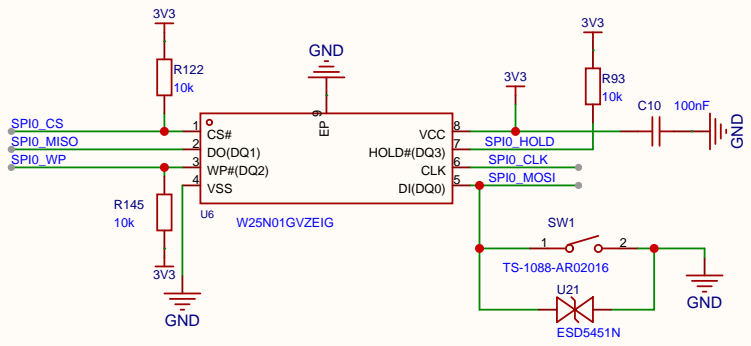
[picture p70: figure]
CS# 1 DO(DQ1) 2 WP#(DQ2) 3 VSS 4; CLK 6; HOLD#(DQ3) 7; VCC 8; W25N01GVZEIG; SPI0_CS SPI0_MISO; GND; SPI0_MOSI; SPI0_WP; SPI0_CLK; SPI0_HOLD; ESD5451N

# MIPI Screen I2C touch

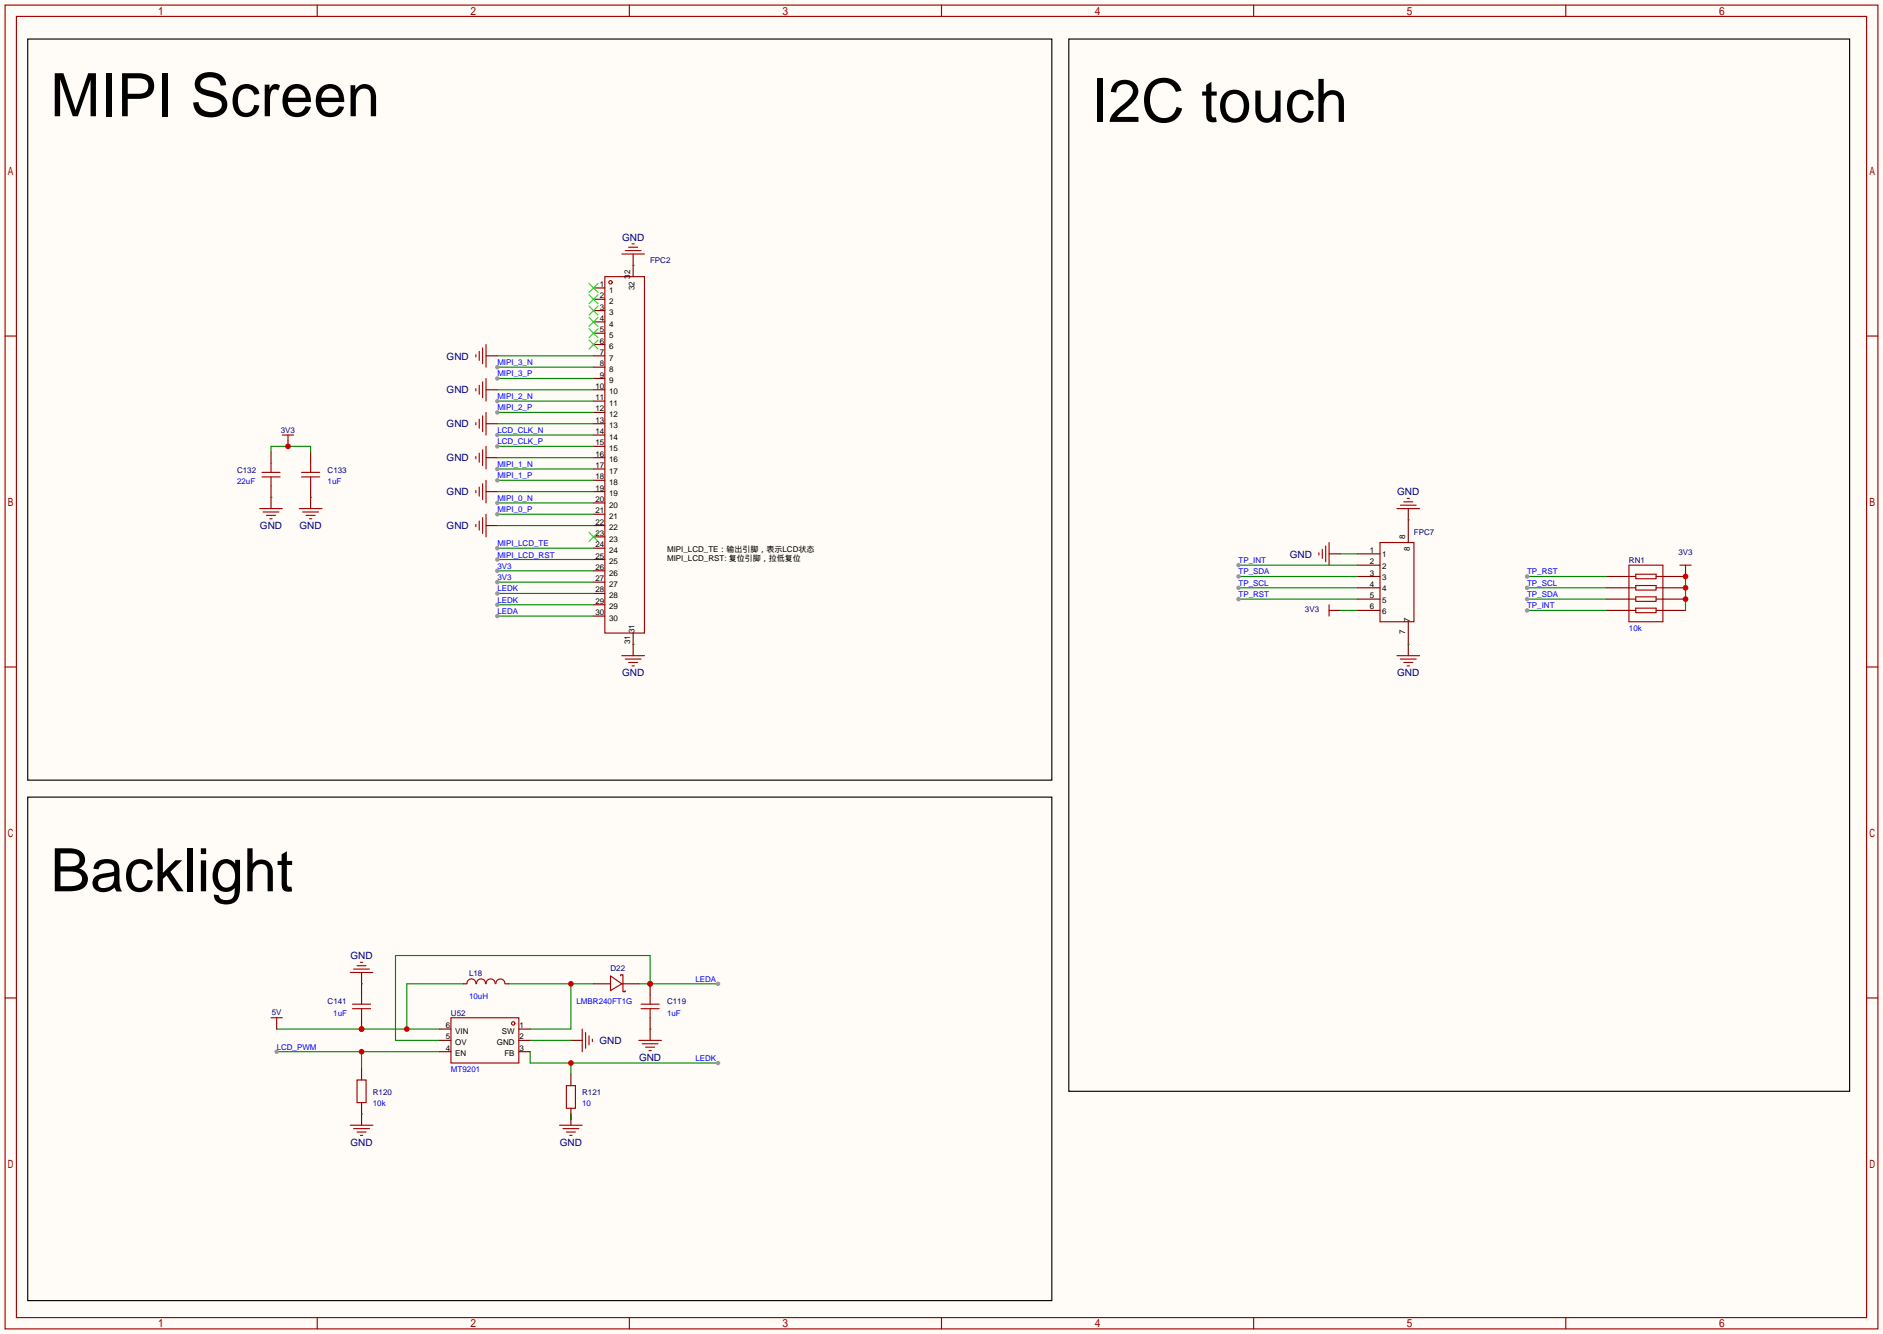
[picture p71: page 7]
