TYF009/AuraBar-T113S3/(commit log)

2026-10-07 Initial commit: AuraBar T113-S3 hardware v1.0
    - LCEDA Pro project, 7-page schematic (PDF + DXF), netlist
    - BOM (xlsx/csv) with LCSC part numbers, 50 unique parts
    - Bilingual (EN-primary/ZH) hardware design guide and requirements
    - T113-S3 + 6.9in MIPI DSI 280x1424 + GT911 touch + RTL8723DS + audio
    [AUDIO.dxf, AuraBar-BOM-v1.0.csv, AuraBar-BOM-v1.0.xlsx, CONNECT.dxf, DISPLAY.dxf, FLASH.dxf, NET.dxf, POWER.dxf]
2026-10-24 docs: record board acceptance and preview delivery limits
2026-10-24 feat: add Desktop Link task companion and device status screen
2026-10-25 fix: avoid redundant task-page redraws and improve scroll interaction
    [main.c, page_about_us.c, page_tasks.c]
